serber/tiny-gps-logger/release/rev1/BOM.md

# BOM, rev1

Fitted parts, grouped by type. Source: `bom-rev1.csv`, the EasyEDA export. 30 lines, 55 parts per board.

## Integrated circuits and modules

| Refs | Qty | Value | Part | Manufacturer | Package | LCSC |
|---|---|---|---|---|---|---|
| U1 | 1 | MAX-M10S-00B | `MAX-M10S-00B` | U-BLOX | SMD-18 | [C4153167](https://www.lcsc.com/product-detail/C4153167.html) |
| U2 | 1 | STM32L412KBU6 | `STM32L412KBU6` | ST | UFQFPN-32 | [C529439](https://www.lcsc.com/product-detail/C529439.html) |
| U3 | 1 | RT9080-33GJ5 | `RT9080-33GJ5` | RICHTEK | TSOT-23-5 | [C841192](https://www.lcsc.com/product-detail/C841192.html) |
| U4 | 1 | MCP73831T-2ACI/OT | `MCP73831T-2ACI/OT` | MICROCHIP | SOT-23-5 | [C424093](https://www.lcsc.com/product-detail/C424093.html) |
| U5 | 1 | USBLC6-2SC6 | `USBLC6-2SC6` | ST | SOT-23-6 | [C7519](https://www.lcsc.com/product-detail/C7519.html) |

## Transistors

| Refs | Qty | Value | Part | Manufacturer | Package | LCSC |
|---|---|---|---|---|---|---|
| Q1 | 1 | AO3401A | `AO3401A` | AOS | SOT-23 | [C15127](https://www.lcsc.com/product-detail/C15127.html) |

## Diodes and LEDs

| Refs | Qty | Value | Part | Manufacturer | Package | LCSC |
|---|---|---|---|---|---|---|
| D1 | 1 | Green LED | `KT-0603G` | KENTO | 0603 | [C12624](https://www.lcsc.com/product-detail/C12624.html) |
| D2 | 1 | Red LED | `KT-0603R` | KENTO | 0603 | [C2286](https://www.lcsc.com/product-detail/C2286.html) |
| D3 | 1 | BAT54WS | `BAT54WS` | Hottech | SOD-323 | [C191198](https://www.lcsc.com/product-detail/C191198.html) |
| D4 | 1 | B5819WS | `B5819WS` | YANGJIE | SOD-323 | [C699105](https://www.lcsc.com/product-detail/C699105.html) |

## Capacitors

| Refs | Qty | Value | Part | Manufacturer | Package | LCSC |
|---|---|---|---|---|---|---|
| C1, C4, C12, C16 | 4 | 1 µF 50 V X5R | `CL10A105KB8NNNC` | SAMSUNG | 0603 | [C15849](https://www.lcsc.com/product-detail/C15849.html) |
| C2, C6, C7, C11 | 4 | 4.7 µF 16 V X5R | `CL10A475KO8NNNC` | SAMSUNG | 0603 | [C19666](https://www.lcsc.com/product-detail/C19666.html) |
| C3 | 1 | 47 µF 6.3 V X5R | `CL21A476MQYNNNE` | SAMSUNG | 0805 | [C16780](https://www.lcsc.com/product-detail/C16780.html) |
| C5, C8, C9, C10, C13, C14, C15, C17, C20 | 9 | 100 nF 50 V X7R | `CL10B104KB8NNNC` | SAMSUNG | 0603 | [C1591](https://www.lcsc.com/product-detail/C1591.html) |
| C19 | 1 | 10 µF 10 V X5R | `CL10A106KP8NNNC` | SAMSUNG | 0603 | [C19702](https://www.lcsc.com/product-detail/C19702.html) |

## Resistors

| Refs | Qty | Value | Part | Manufacturer | Package | LCSC |
|---|---|---|---|---|---|---|
| R1 | 1 | 100 kΩ 1% | `RC0603FR-07100KL` | YAGEO | 0603 | [C14675](https://www.lcsc.com/product-detail/C14675.html) |
| R2, R3 | 2 | 220 kΩ 1% | `RC0603FR-07220KL` | YAGEO | 0603 | [C123420](https://www.lcsc.com/product-detail/C123420.html) |
| R4, R5 | 2 | 5.1 kΩ 1% | `RC0603FR-075K1L` | YAGEO | 0603 | [C105580](https://www.lcsc.com/product-detail/C105580.html) |
| R6 | 1 | 20 kΩ 1% | `RC0603FR-0720KL` | YAGEO | 0603 | [C105575](https://www.lcsc.com/product-detail/C105575.html) |
| R7, R12, R13 | 3 | 1 kΩ 1% | `RC0603FR-071KL` | YAGEO | 0603 | [C22548](https://www.lcsc.com/product-detail/C22548.html) |
| R8, R9, R10 | 3 | 10 kΩ 1% | `RC0603FR-0710KL` | YAGEO | 0603 | [C98220](https://www.lcsc.com/product-detail/C98220.html) |
| R11 | 1 | 33 Ω 1% | `RC0603FR-0733RL` | YAGEO | 0603 | [C108661](https://www.lcsc.com/product-detail/C108661.html) |
| R15, R16, R17, R18, R19, R20 | 6 | 47 kΩ 1% | `RC0603FR-0747KL` | YAGEO | 0603 | [C105579](https://www.lcsc.com/product-detail/C105579.html) |

## Connectors and mechanics

| Refs | Qty | Value | Part | Manufacturer | Package | LCSC |
|---|---|---|---|---|---|---|
| BT1 | 1 | GNSS backup cell | `MS621FE-FL11E` | Seiko | BAT-SMD_FL11E | [C80909](https://www.lcsc.com/product-detail/C80909.html) |
| J1 | 1 | Battery connector | `BX-SH1.0-2PWT` | Bossie | CONN-SMD | [C18077908](https://www.lcsc.com/product-detail/C18077908.html) |
| J2 | 1 | TYPE-C-31-M-12 | `TYPE-C-31-M-12` | HRO | USB-C | [C165948](https://www.lcsc.com/product-detail/C165948.html) |
| J3 | 1 | U.FL antenna connector | `U.FL-R-SMT-1(80)` | HRS | RF-SMD | [C88374](https://www.lcsc.com/product-detail/C88374.html) |
| J4 | 1 | microSD slot, push-push | `TF PUSH` | SHOU HAN | TF-SMD_TF-PUSH | [C393941](https://www.lcsc.com/product-detail/C393941.html) |
| J5 | 1 | Debug header 1×7, 1.27 mm | `MTP315-1107S1` | MINTRON | HDR-TH | [C5142369](https://www.lcsc.com/product-detail/C5142369.html) |

## Switches and buzzers

| Refs | Qty | Value | Part | Manufacturer | Package | LCSC |
|---|---|---|---|---|---|---|
| SW1 | 1 | Slide switch | `SSSS811101` | ALPSALPINE | SW-SMD | [C109335](https://www.lcsc.com/product-detail/C109335.html) |

## Do not fit

| Refs | Note |
|---|---|
| L1 | 27 nH, active antenna supply |
| R14 | 10 Ω, `RC0603FR-0710RL` ([C109318](https://www.lcsc.com/product-detail/C109318.html)), active antenna supply |
| C18 | 10 nF, `CL10B103KB8NNNC` ([C1589](https://www.lcsc.com/product-detail/C1589.html)), active antenna supply |

They are in the placement file: remove them if a fabricator assembles the board.

## Not on the BOM

| Item | Qty | Note |
|---|---|---|
| LP502030-PCM Li-Po battery | 1 | To `J1` |
| Mating plug for `J1` | 1 | |

## Notes

- `J4` is on the bottom side. All other parts are on the top side.
- `BT1` (`MS621FE`) is not reflowable: solder it by hand, last.
- `D3` stays Hottech `BAT54WS`: LRC `LBAT54HT1G` has a different library footprint.
- The `Device` column of `placement-rev1.csv` still names the old library part for passives changed on 2026-11-09. Fit the parts in this BOM.
- Stock and prices were not checked.
