serber/tiny-gps-logger/release/rev1/bom-rev1.csv

No. | Quantity | Comment | Designator | Footprint | Value | Manufacturer Part | Manufacturer | Supplier Part | Supplier
1 | 1 | MS621FE-FL11E | BT1 | BAT-SMD_FL11E |  | MS621FE-FL11E | Seiko(精工) | C80909 | LCSC
2 | 4 | 1uF | C1,C4,C12,C16 | C0603 | 1uF | CL10A105KB8NNNC | SAMSUNG(三星) | C15849 | LCSC
3 | 4 | 4.7uF | C2,C6,C7,C11 | C0603 | 4.7uF | CL10A475KO8NNNC | SAMSUNG(三星) | C19666 | LCSC
4 | 1 | 47uF | C3 | C0805 | 47uF | CL21A476MQYNNNE | SAMSUNG(三星) | C16780 | LCSC
5 | 9 | 100nF | C5,C8,C9,C10,C13,C14,C15,C17,C20 | C0603 | 100nF | CL10B104KB8NNNC | SAMSUNG(三星) | C1591 | LCSC
6 | 1 | 10uF | C19 | C0603 | 10uF | CL10A106KP8NNNC | SAMSUNG(三星) | C19702 | LCSC
7 | 1 | KT-0603G | D1 | LED0603-RD |  | KT-0603G | KENTO | C12624 | LCSC
8 | 1 | KT-0603R | D2 | LED-SMD_L1.6-W0.8-R-RD |  | KT-0603R | KENTO | C2286 | LCSC
9 | 1 | BAT54WS | D3 | SOD-323_L1.7-W1.3-LS2.6-RD |  | BAT54WS | Hottech(合科泰) | C191198 | LCSC
10 | 1 | B5819WS | D4 | SOD-323_L1.8-W1.3-LS2.5-RD |  | B5819WS | YANGJIE(扬杰) | C699105 | LCSC
11 | 1 | BX-SH1.0-2PWT | J1 | CONN-SMD_2P-P1.00_BX-SH1.0-2PWT |  | BX-SH1.0-2PWT | Bossie(博锡) | C18077908 | LCSC
12 | 1 | TYPE-C-31-M-12 | J2 | USB-C_SMD-TYPE-C-31-M-12_1 |  | TYPE-C-31-M-12 | 韩国韩荣 | C165948 | LCSC
13 | 1 | 6GHz | J3 | RF-SMD_FRF05002-JSS103M | 6GHz | U.FL-R-SMT-1(80) | HRS(广濑) | C88374 | LCSC
14 | 1 | TF PUSH | J4 | TF-SMD_TF-PUSH |  | TF PUSH | SHOU HAN(首韩) | C393941 | LCSC
15 | 1 | MTP315-1107S1 | J5 | HDR-TH_7P-P1.27-V-M |  | MTP315-1107S1 | MINTRON(明硕) | C5142369 | LCSC
16 | 1 | AO3401A | Q1 | SOT-23_L2.9-W1.3-P1.90-LS2.4-BR |  | AO3401A | AOS | C15127 | LCSC
17 | 1 | 100kΩ | R1 | R0603 | 100kΩ | RC0603FR-07100KL | YAGEO(国巨) | C14675 | LCSC
18 | 2 | 220kΩ | R2,R3 | R0603 | 220kΩ | RC0603FR-07220KL | YAGEO(国巨) | C123420 | LCSC
19 | 2 | 5.1kΩ | R4,R5 | R0603 | 5.1kΩ | RC0603FR-075K1L | YAGEO(国巨) | C105580 | LCSC
20 | 1 | 20kΩ | R6 | R0603 | 20kΩ | RC0603FR-0720KL | YAGEO(国巨) | C105575 | LCSC
21 | 3 | 1kΩ | R7,R12,R13 | R0603 | 1kΩ | RC0603FR-071KL | YAGEO(国巨) | C22548 | LCSC
22 | 3 | 10kΩ | R8,R9,R10 | R0603 | 10kΩ | RC0603FR-0710KL | YAGEO(国巨) | C98220 | LCSC
23 | 1 | 33Ω | R11 | R0603 | 33Ω | RC0603FR-0733RL | YAGEO(国巨) | C108661 | LCSC
24 | 6 | 47kΩ | R15,R16,R17,R18,R19,R20 | R0603 | 47kΩ | RC0603FR-0747KL | YAGEO(国巨) | C105579 | LCSC
25 | 1 | SSSS811101 | SW1 | SW-SMD_SSSS811101 |  | SSSS811101 | ALPSALPINE(阿尔卑斯阿尔派) | C109335 | LCSC
26 | 1 | MAX-M10S-00B | U1 | SMD-18_L10.1-W9.7-P1.10-TL_SKG09F |  | MAX-M10S-00B | U-BLOX(优北罗) | C4153167 | LCSC
27 | 1 | STM32L412KBU6 | U2 | UFQFPN-32_L5.0-W5.0-P0.50-BL-EP3.5 |  | STM32L412KBU6 | ST(意法半导体) | C529439 | LCSC
28 | 1 | RT9080-33GJ5 | U3 | TSOT-23-5_L2.9-W1.6-P0.95-LS2.8-BL |  | RT9080-33GJ5 | RICHTEK(立锜) | C841192 | LCSC
29 | 1 | MCP73831T-2ACI/OT | U4 | SOT-23-5_L3.0-W1.7-P0.95-LS2.8-BL |  | MCP73831T-2ACI/OT | MICROCHIP(美国微芯) | C424093 | LCSC
30 | 1 | USBLC6-2SC6 | U5 | SOT-23-6_L2.9-W1.6-P0.95-LS2.8-BL |  | USBLC6-2SC6 | ST(意法半导体) | C7519 | LCSC
