serber/tiny-gps-logger/firmware/Inc/main.h

#define VBAT_SENSE_Pin LL_GPIO_PIN_0
#define VBAT_SENSE_GPIO_Port GPIOA
#define VBUS_SENSE_Pin LL_GPIO_PIN_1
#define VBUS_SENSE_GPIO_Port GPIOA
#define SD_CS_Pin LL_GPIO_PIN_4
#define SD_CS_GPIO_Port GPIOA
#define SD_SCK_MCU_Pin LL_GPIO_PIN_5
#define SD_SCK_MCU_GPIO_Port GPIOA
#define SD_MISO_Pin LL_GPIO_PIN_6
#define SD_MISO_GPIO_Port GPIOA
#define SD_MOSI_Pin LL_GPIO_PIN_7
#define SD_MOSI_GPIO_Port GPIOA
#define SD_DET_Pin LL_GPIO_PIN_0
#define SD_DET_GPIO_Port GPIOB
#define GPS_EXTINT_Pin LL_GPIO_PIN_1
#define GPS_EXTINT_GPIO_Port GPIOB
#define GPS_TP_Pin LL_GPIO_PIN_8
#define GPS_TP_GPIO_Port GPIOA
#define LED_STATUS_Pin LL_GPIO_PIN_3
#define LED_STATUS_GPIO_Port GPIOB
#define GPS_RESET_Pin LL_GPIO_PIN_4
#define GPS_RESET_GPIO_Port GPIOB
#define GPS_RXD_Pin LL_GPIO_PIN_6
#define GPS_RXD_GPIO_Port GPIOB
#define GPS_TXD_Pin LL_GPIO_PIN_7
#define GPS_TXD_GPIO_Port GPIOB
#define NVIC_PRIORITYGROUP_0         ((uint32_t)0x00000007) /*!< 0 bit  for pre-emption priority,
#define NVIC_PRIORITYGROUP_1         ((uint32_t)0x00000006) /*!< 1 bit  for pre-emption priority,
#define NVIC_PRIORITYGROUP_2         ((uint32_t)0x00000005) /*!< 2 bits for pre-emption priority,
#define NVIC_PRIORITYGROUP_3         ((uint32_t)0x00000004) /*!< 3 bits for pre-emption priority,
#define NVIC_PRIORITYGROUP_4         ((uint32_t)0x00000003) /*!< 4 bits for pre-emption priority,
