serber/tiny-gps-logger/(commit log)

2026-11-05 Add PCB design records and firmware board reference
2026-11-05 Add fabrication order text to the PCB spec
2026-11-05 Add README with board renders
2026-11-05 Release PCB revision 1 fabrication files
    [tiny-gps-logger-rev1-bom.csv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]
2026-11-06 Move the PCB package to the shared release layout
    Put the release in release/rev1, the design records in docs/, and the renders in docs/images. Add an Ordering section to the README, and generate BOM.md from the EasyEDA export.
    [bom-rev1.csv, placement-rev1.csv]
2026-11-06 Add alpha firmware
    Bare-metal C11 firmware on STM32Cube LL and FatFs R0.16: GPS over USART1
    with DMA, CSV logging to microSD over SPI, battery and USB sensing, LED
    patterns and a jump to the USB bootloader. Host tests cover UBX, CSV,
    start-up decisions and logging on a RAM disk. Nothing has run on hardware.
    Add the specification, and a build and flashing guide to the README.
2026-11-07 Spread crowded parts and re-export rev1
    Move J3, L1, R12, D1, D3, C16, C17, R13, C5 and C14 to clear
    silkscreen overlaps, and rework the local copper. DRC is clean.
    Export the Gerber and placement files again and replace the README
    renders with EasyEDA 3D views. Nothing has been built or measured.
    [placement-rev1.csv]
2026-11-09 Align passives with the other boards
    Use the same Samsung CL and Yageo RC parts as marauder-c5-pancake-board,
    solar-power-module-CN3722 and lmp91000-afe, so one order covers them all.
    Values without a match move to the same series. D3 and U5 are kept.
    Attributes changed in place; footprints, nets and copper unchanged.
    DRC 0 errors. BOM and placement exported again.
    [bom-rev1.csv, placement-rev1.csv]
2026-11-09 Unify board docs, BOM and release layout
    - BOM grouped by part type in a fixed order, one row per order code,
    values decoded from Samsung CL and Yageo RC/RT part numbers
    - Release README: export, file table, checks, not verified
    - README sections: status, features, specifications, ordering, BOM, repository
    - Design records in docs/SPEC.md and docs/DESIGN-RECORD.md; duplicate
    and superseded content removed
2026-11-10 Order boards with lead-free HASL instead of ENIG
    ENIG raised the fab quote. The boards are hand-assembled with hot air
    and a bottom preheater, so 0.5 mm pitch parts and USB-C work on HASL.
    ENIG stays mentioned as a paid option. Board size removed from the
    order line; the fab reads it from the Gerbers.
